amosborne/rp2040-isp-stamp/README.md

# RP2040 ISP Stamp

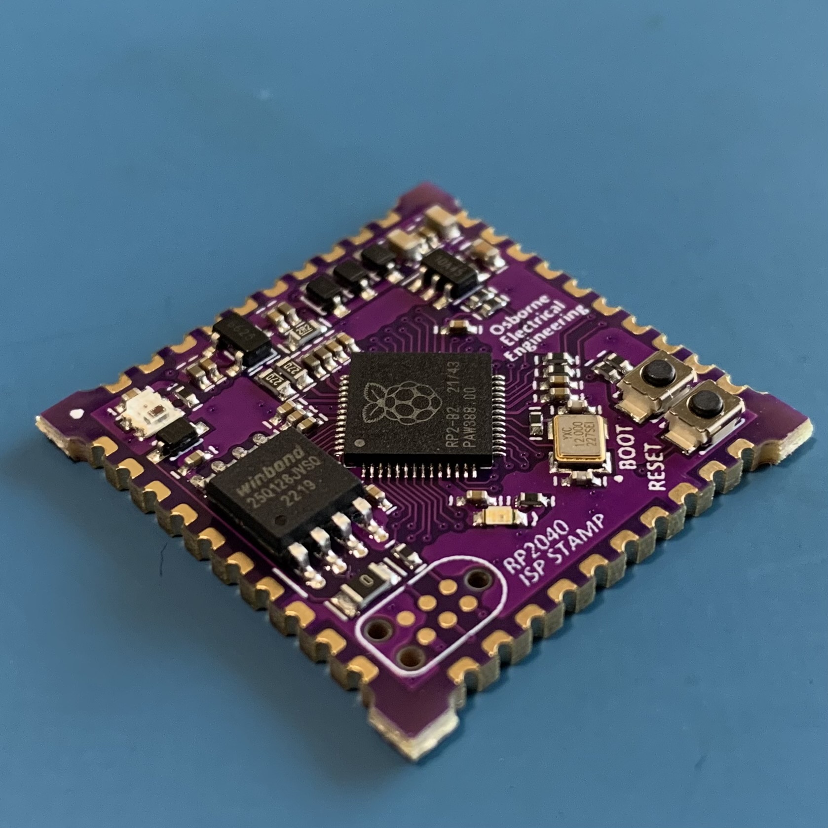
[picture p1: rp2040_isp_stamp.JPG]
isometric

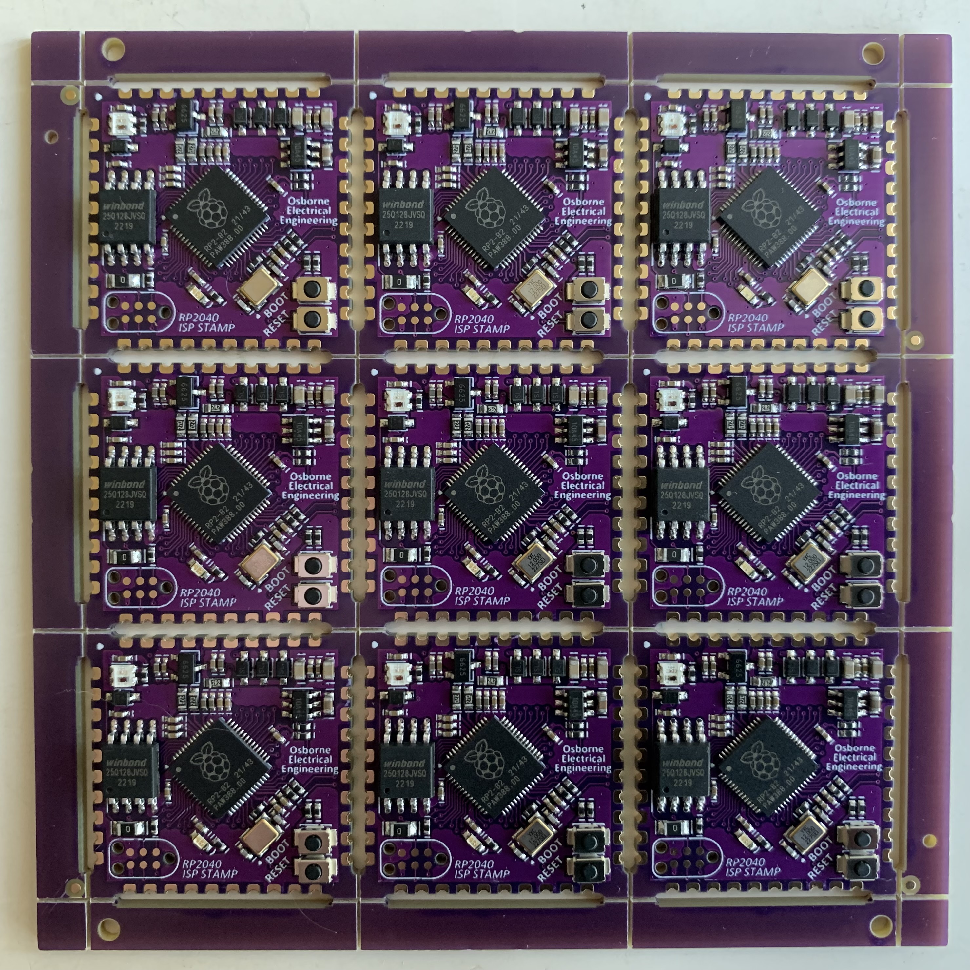
[picture p2: rp2040_isp_stamp_panel.JPG]
panel
