amosborne/rp2040-isp-stamp/rp2040_isp_stamp_carrier.JPG

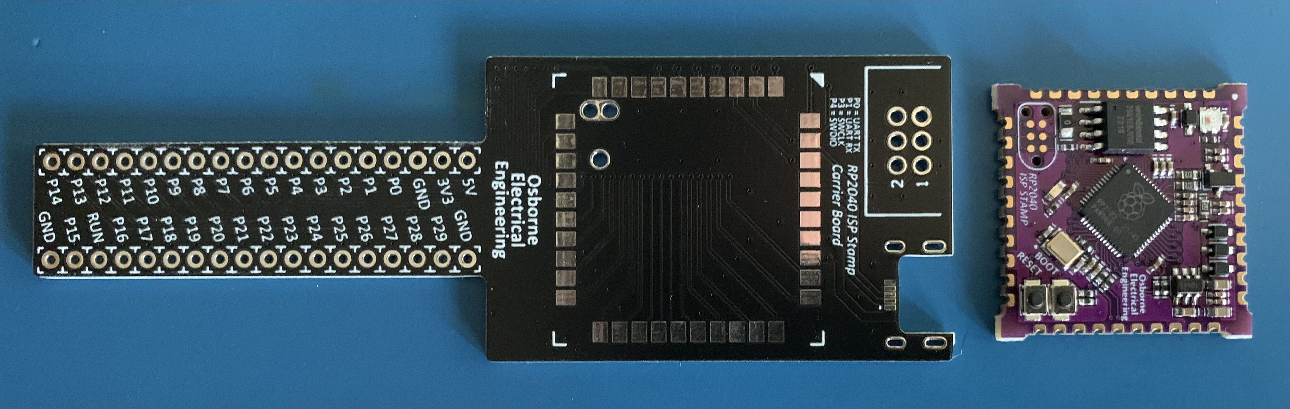
rp2040_isp_stamp_carrier.JPG
