amosborne/rp2040-isp-stamp/rp2040_isp_stamp/doc/assembly.PDF

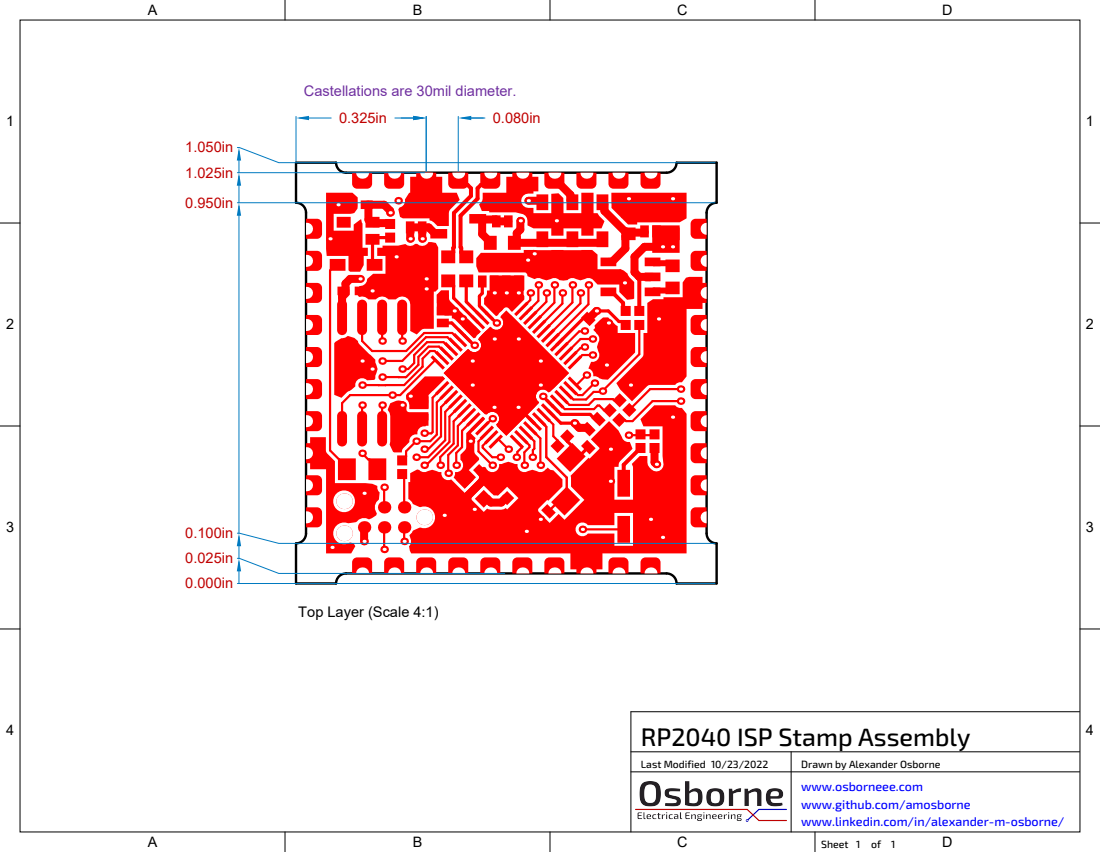
[picture p6: page 1]
Last Modified 10/23/2022; Drawn by Alexander Osborne

Castellations are 30mil diameter.

Top Layer (Scale 4:1)

RP2040 ISP Stamp Assembly

www.osborneee.com
www.github.com/amosborne
www.linkedin.com/in/alexander-m-osborne/
Sheet 1 of 1
