amosborne/rp2040-isp-stamp/rp2040_isp_stamp_carrier/doc/rp2040_isp_stamp_carrier.PDF

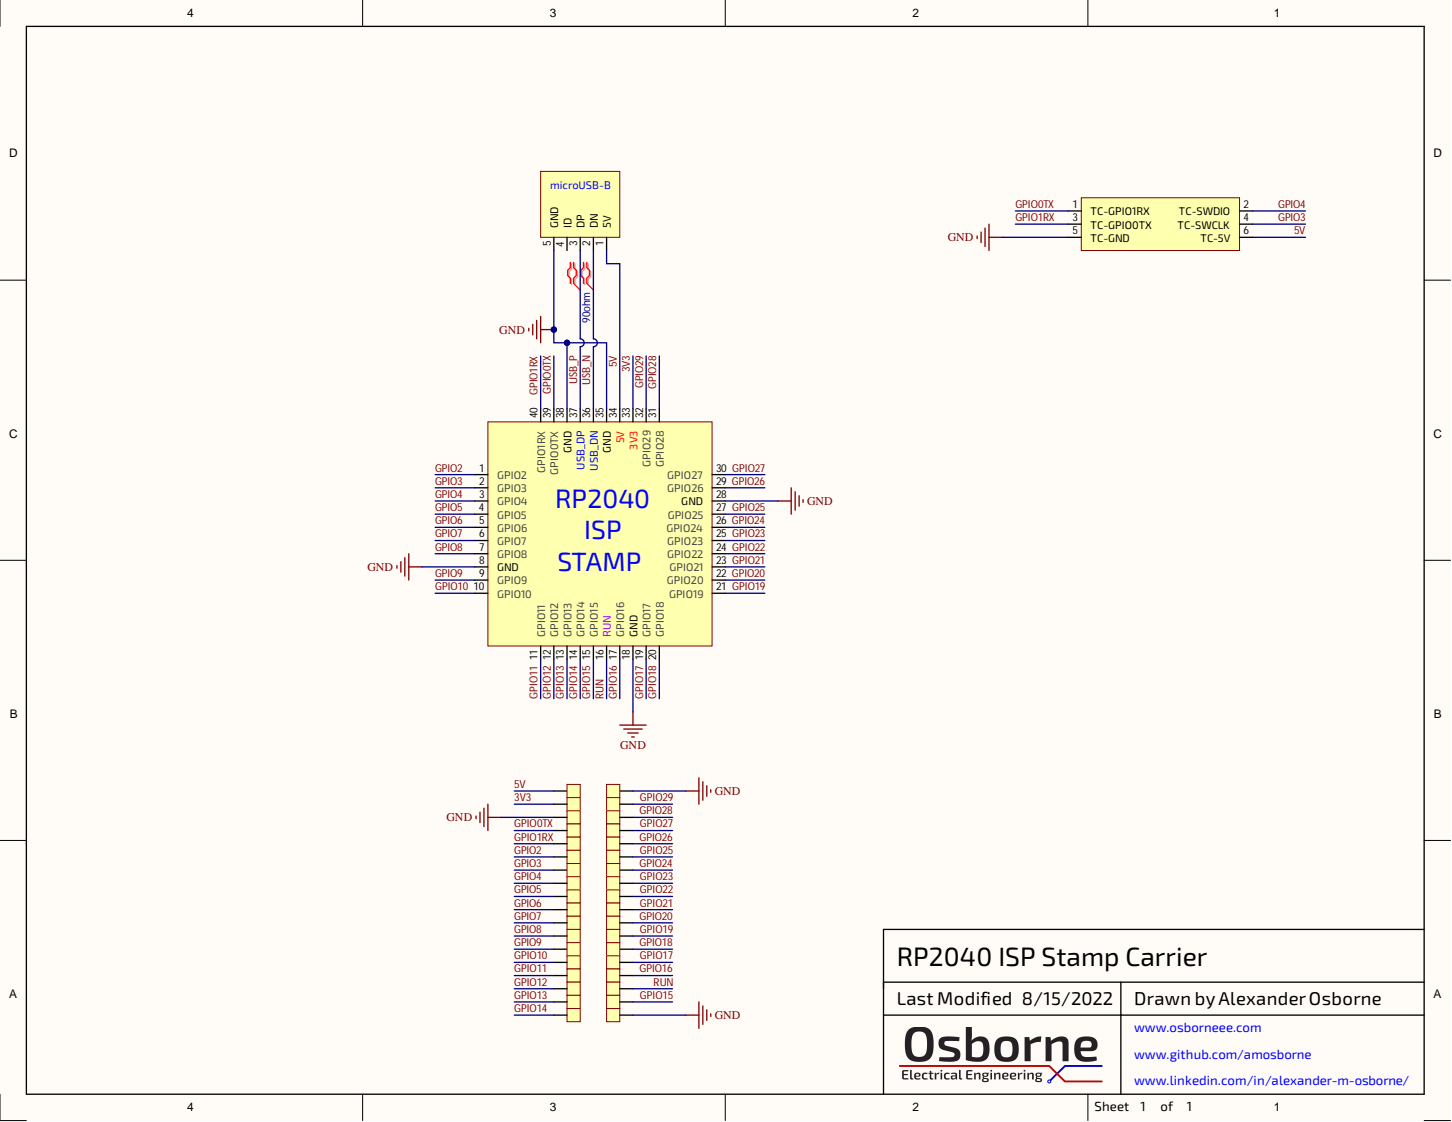
[picture p7: page 1]

5V 1 DN 2 DP 3 ID 4 GND 5 microUSB-B

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

www.osborneee.com www.gi t hub.com/ amosborn e www.li n kedi n.com/ i n / alexa nder -m-osbor n e /

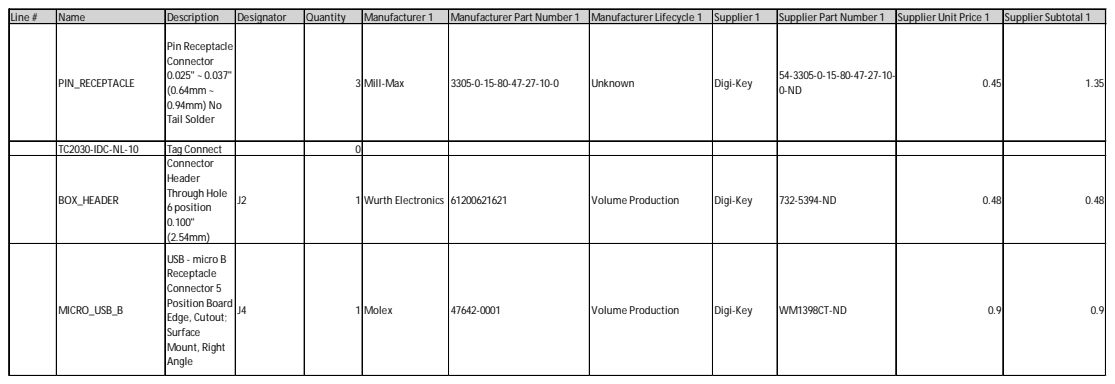
[picture p8: page 2]

Line # | Name | Description | Designator | Quantity | Manufacturer 1 | Manufacturer Part Number 1 | Manufacturer Lifecycle 1 | Supplier 1 | Supplier Part Number 1 | Supplier Unit Price 1 | Supplier Subtotal 1

PIN_RECEPTACLE | Pin Receptacle Connector 0.025" ~ 0.037" (0.64mm ~ 0.94mm) No Tail Solder | | 3 Mill-Max | | 3305-0-15-80-47-27-10-0 | Unknown | Digi-Key | 54-3305-0-15-80-47-27-10-0-ND | 0.45 | 1.35

TC2030-IDC-NL-10 | Tag Connect | | 0
BOX_HEADER | Connector Header Through Hole 6 position 0.100" (2.54mm) | J2 | 1 Wurth Electronics | | 61200621621 | Volume Production | Digi-Key | 732-5394-ND | 0.48 | 0.48

MICRO_USB_B | USB - micro B Receptacle Connector 5 Position Board Edge, Cutout; Surface Mount, Right Angle | J4 | 1 Molex | | 47642-0001 | Volume Production | Digi-Key | WM1398CT-ND | 0.9 | 0.9
