amosborne/rp2040-isp-stamp/analysis/ideal_diode/simulation.asc

D1: diode; Dideal
I1: current; 125m
M1: pmos; Si2301CDS
Q1: pnp; DI_DMMT3906
Q2: pnp; DI_DMMT3906
R1: res; 8.2k
R2: res; 4.7k
R3: res; 390m
V1: voltage; PWL(0 3.3 1 3.3 1.001 0)
V2: voltage; PWL(0 3.4 1 3.24 2 3.4)
Named nets: 0, vg, vs, vin, vd
.include si2301cds_ps_rc.lib
.tran 2
.include DMMT3906.spice
.model Dideal D(Ron=0.0001 Roff=100G Vfwd=0)
