amosborne/rp2040-isp-stamp/(list of files, drawings)

Other design files:
rp2040_isp_stamp/pcb/pcb_v2.PcbDoc
rp2040_isp_stamp/pcb/rp2040_isp_stamp_panel.PcbDoc
rp2040_isp_stamp/rp2040_isp_stamp.PrjPcb
rp2040_isp_stamp/sch/schematic.SchDoc
rp2040_isp_stamp_carrier/pcb/pcb.PcbDoc
rp2040_isp_stamp_carrier/rp2040_isp_stamp_carrier.PrjPcb
rp2040_isp_stamp_carrier/sch/schematic.SchDoc
