amosborne/rp2040-isp-stamp/(commit log)

2022-06-13 ideal diode analysis
2022-06-14 draft schematic
    [rp2040_isp_stamp.PrjPcb, schematic.SchDoc]
2022-06-16 more sch work
    [schematic.SchDoc]
2022-06-17 complete sch
    [rp2040_isp_stamp.PrjPcb, schematic.SchDoc]
2022-06-18 initial component placement
    [pcb.PcbDoc, rp2040_isp_stamp.PrjPcb, schematic.SchDoc]
2022-06-19 placement updates
    [pcb.PcbDoc, rp2040_isp_stamp.PrjPcb, schematic.SchDoc]
2022-06-20 preliminary layout
    [pcb.PcbDoc]
2022-06-20 initial schematic
    [rp2040_isp_stamp_carrier.PrjPcb, schematic.SchDoc]
2022-06-20 draft carrier
    [pcb.PcbDoc, rp2040_isp_stamp_carrier.PrjPcb, schematic.SchDoc]
2022-06-24 add tag connect pin receptacles
    [pcb.PcbDoc, rp2040_isp_stamp_carrier.PrjPcb, schematic.SchDoc]
2022-08-14 new layout & fab files
    [Bill of Materials CSV-rp2040_isp_stamp.csv, Pick Place for pcb_v2.csv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]
2022-08-14 stamp sch/pcb touchup
    [Pick Place for pcb_v2.csv, pcb.PcbDoc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]
2022-08-15 new carrier design
    [pcb.PcbDoc, rp2040_isp_stamp_carrier.PrjPcb, schematic.SchDoc]
2022-08-15 stamp carrier fab files
    [rp2040_isp_stamp_carrier.PrjPcb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]
2022-08-17 fix usb ref plane
    [Pick Place for pcb_v2.csv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]
2022-08-17 adjust castellations
    [Pick Place for pcb_v2.csv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]
2022-08-18 flare out pcb corners
    [Pick Place for pcb_v2.csv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]
2022-08-18 create panel
    [Bill of Materials CSV-pcb_v2.csv, Pick Place for pcb_v2.csv, Pick Place for rp2040_isp_stamp_panel.csv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]
2022-08-18 remove order no
    [Pick Place for rp2040_isp_stamp_panel.csv, pcb_v2.PcbDoc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]
2022-08-18 update carrier pitch
    [pcb.PcbDoc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]
2022-09-09 add pics
    [rp2040_isp_stamp.PrjPcb]
2022-10-23 document assembly outline
    [rp2040_isp_stamp.PrjPcb]
